bogdanChisalescu/Project-2/Documentation/Project_Documentation.pdf

## Proiect 2 - Documentatie Minisistem pentru irigat plante

Chisalescu Bogdan si Floricel Antonio - Stefan Grupa 432A

Coordonator stiintific: S.l. dr. ing. Valentin Stoica

1

### Cuprins

2

### 1 Cerinta de proiectare

Implementarea unui minisistem pentru irigat plante folosind microcontrolerul Atmel AVR ATmega 164A. Realizarea fizica trebuie efectuata pe o placa de cablaj imprimat cu componente SMD furnizata de catre facultate, insa datorita conditiilor epidemiologice si masurilor luate de Conducerile ETTI si UPB aceasta modalitate de realizare nu a fost posibila; masurile de distantare sociala si invatamant in regim ”online” au facut impractic accesul la aparatura necesara, astfel am decis realizarea proiectului pe placi de prototipare si cu componente THT. Realizarea in formatul SMD + placa de circuit imprimat s-ar fi putut realiza de catre un singur membru al echipei insa in acest mod contributia asupra proiectului ar fi fost sever dezechilibrata. Intelegem ca in urma acestei decizi se pierd anumite avantaje precum stabilitatea cu temperatura, zgomotul redus, costul redus, etc.

### 2 Solutia de implementare propusa

Pentru a implementa minisistemul de irigat plante vom avea nevoie de doua clase principale de componente: senzori si actuatori. Actiunea de a iriga plantele consta in transferul unei cantitati de apa dintr-un rezervor catre plante. Pentru a decide momentul irigarii si a o efectua este nevoie de prelucrarea marimilor fizice implicate si anume umiditatea solului si disponibilitatea apei din rezervor reprezentata prin nivel (inaltimea coloanei de apa). Pentru a extrage si cuantifica aceste marimi vom folosi un senzor de umiditate a solului si unul de nivel. Pentru transportul apei de la rezervor la plante vom folosi ca actuator o minipompa de apa. Pentru a facilita interactiunea cu sistemul al unui posibil utilizator vom dezvolta o aplicatie desktop ce va asigura transmisia de date de configurare plus o serie de informatii despre starea sistemului in timp real.

3

### 3 Schema bloc a sistemului

Schema bloc a sistemului reprezinta arhitectura generala si descrie modul conceptual de interconectare a componentelor. Se poate observa o comunicatie unilaterala intre blocuri precum senzorii si microcontroler si o comunicatie bilaterala intre microcontroler si aplicatia utilizatorului, acestea semnificand sensul de transmitere al informatiei.


Figure 1: Schema bloc a minisistemului de irigat plante

### 4 Incarcarea codului pe microcontroler

Microcontrolerul dispune de mai multe modalitati prin care poate fi programat. Cele care sunt de interes sunt programarea folosind un programator dedicat si programarea folosind un bootloader. Utilizarea programatorului dedicat este simpla intrucat este necesara doar conexiunea sa catre PC prin portul USB si realizarea conxiunilor catre pinii dedicati ai microcontrolerului. Utilizarea bootloaderului presupune intai scrierea acestuia intr-o memorie nonvolatila, spatiul rezervat acestuia fiind in adresele superioare are memoriei Flash de program. Dupa incarcarea bootloaderului nu mai este

4

nevoie de programatorul dedicat deoarece in procesul de programare al microcontrolerului bootloaderul preia controlul folosind ce interfata seriala are la dispozitie, incarca aplicatia ce va rula pe microcontroler in memroia de program si ulterior ii cedeaza acesteia controlul executiei. In aceasta lucrare am optat pentru incarcarea codului cu un programator dedicat deoarece ne confera mai multe functionalitati. Am ales pentru elaborarea codului mediul de dezvoltare Atmel Studio 7 acesta fiind creat special pentru programarea microcontrolerelor fabricate de Atmel. Cu ajutorul Atmel Studio si compilatorului GCC vom crea un fisier cu extensia .hex ce va fi incarcat pe microcontroler de catre softul ”avrdude” folosind comanda ”avrdude -c usbasp -p m164p -U flash:w:$(ProjectDir)Debug $(TargetName).hex:i”. Deoarece avrdude nu ofera suport pentru modelul ATmega 164A, am modificat in fisierul de configurare al avrdude semnatura dispozitivului alegand cel mai apropiat dispozitiv ca arhitectura de ATmega 164A, acesta fiind ATmega 164P.

Figure 2: Modul in care se incarca codul pe uC

### 5 Cuplarea unui oscilator extern

Atmega 164A pune la dispozitie o multitudine de optiuni cand vine vorba de alegerea sursei pentru ceasul intern; acesta vine echipat cu un oscilator RC intern calibrat la frecventa de 8 MHz, iar pentru ceasul de sistem aceasta frecventa este impartita la 8, de unde rezulta 1 MHz, astfel in mod implicit microcontrolerul ruleaza la o frecventa de ceas de 1 MHz. Deoarece aceasta frecventa de 1 MHz este in anumite situatii un factor limitator de performanta vom cupla un oscilator extern cu cristal de quartz de 20 MHz. Pentru a determina microcontrolerul sa foloseasca acest oscilator ca sursa pentru

5

ceasul de sistem este nevoie sa fie modificati bitii fuse. Bitii fuse sunt localizati intr-o zona rezervata din memoria EEPROM iar modificarea acestora se poate face numai cu un programator dedicat deoarece bootloaderul nu poate accesa acel sector al memoriei. Bitii fuse sunt o serie de biti ce ajuta la configurarea microcontrolerului, aceastia formeaza impreuna 3 bytes: High Fuse Byte, Low Fuse Byte si Extended Fuse Byte, pentru fiecare bit ”1” inseamna programat iar ”0” inseamna neprogramat. Pentru a fi siguri ca am programat corect acesti biti am folosit resursa https://www.engbedded.com/fusecalc/, unde am ales tipul de oscilator in conformitate cu foaia de catalog a microcontrolerului adica Full Swing Crystal Oscilator cu timp de pornire cat mai mare ca sa asigure o durata suficienta stabilizarii oscilatiilor si am dezactivat optiunea ce imparte ceasul la 8. Modificarea bitilor fuse a fost efectuata cu programul avrdude folosind comanda ”avrdude -c usbasp -p m164p -U lfuse:w:0xe7:m -U hfuse:w:0x99:m”. Pentru a ne asigura ca microcontrolerul foloseste intradevar frecventa de 20 MHz, am definit in cod frecventa ceasului la un 1 MHz si am tinut aprins un LED timp de 2 secunde. In acest caz frecventa ceasului intern fiind de 1 MHz, LED-ul a stat aprins pentru 2 secunde, exact cat a fost programat(..insert link here...). Am cuplat apoi oscilatorul si am rulat acelasi program, in acest caz LED-ul nu mai sta aprins timp de 2 secunde, ci mult mai putin(...insert linke here...). In cod am definit frecventa de 1 MHz iar microcontrolerul presupune ca aceasta este frecventa ceasului intern si calculeaza in functie de ea timpul pentru care tine LED-ul aprins, iar apoi pentru a-l tine aprins utlizeaza ceasul intern, de aceea chiar daca calculul s-a facut pentru o frecventa de 1 MHz, LED-ul nu va sta aprins pentru 2 secunde deoarece frecventa ceasului este mult mai mare, in acest caz 20 MHz iar timpul in care sta LED-ul aprins este de 0.1 secunde. In urma acestui test putem spune cu exactitate ca microcontrolerul seteaza ceasul intern dupa oscilatorul cuplat.

6

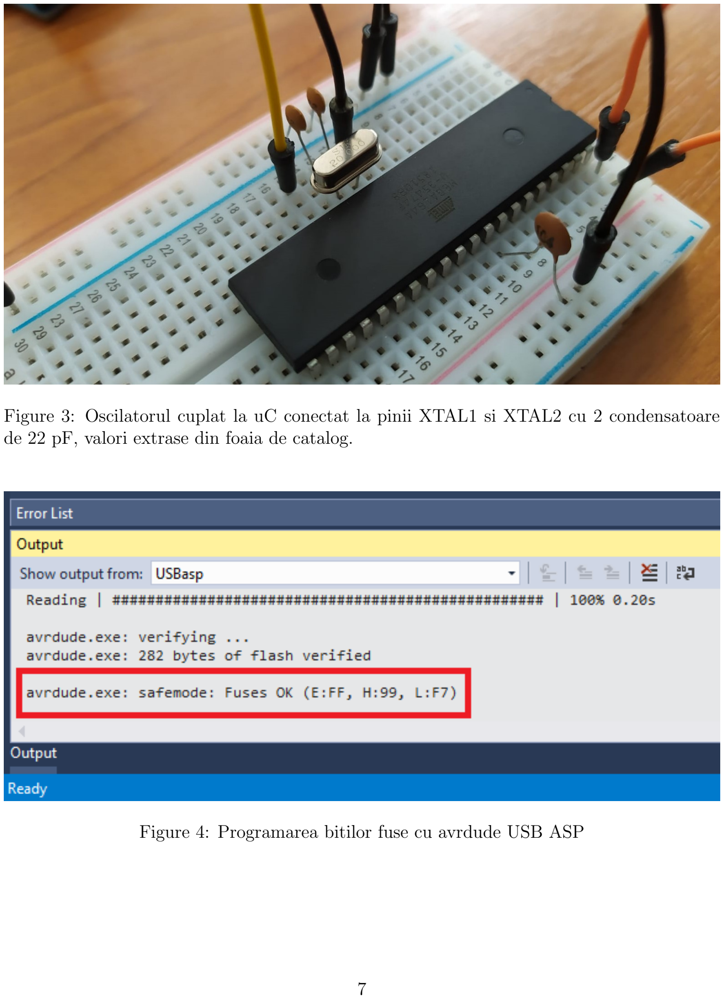
[picture p13: page 7]

Figure 3: Oscilatorul cuplat la uC conectat la pinii XTAL1 si XTAL2 cu 2 condensatoare de 22 pF, valori extrase din foaia de catalog.

Figure 4: Programarea bitilor fuse cu avrdude USB ASP

7

### 6 Comunicatia seriala

Microcontrolerul este capabil de a comunica cu alte dispozitive, aceasta comunicatie asigurandu-se printr-o multitudine de protocoale si interfete, insa ptrintre acestea nu se afla si USB; de aceea pentru a realiza comunicatia intre uC si PC prin intermediul portului USB este nevoie de un convertor USB-TTL. Rolul acestuia este de a adapta interfata folosita de microcontroler pentru comunicatie la cea folosita de PC pentru a se putea efectua schimbul de informatii. Pe tot parcursul desfasurarii proiectului, din cauza lipsei stocului nu am putut face rost de un convertor USB-TTL dedicat, insa am avut la dispozitie o placa de dezvoltare Arduino ce are integrat un astfel de convertor si poate fi configurata sa functioneze si cu alte dispozitive in afara de uC sau integrat. Legand pinul RESET la GND pe placa de dezvoltare Arduino putem suspenda microcontrolerul integrat al placii si folosi convertorul USB-TTL pentru a comunica cu alte dispozitive prin intermediul pinilor RX si TX. Optional, folosind aceasta placa de dezvoltare se poate asigura alimentarea microcontrolerului.


Figure 5: Placa de dezvoltare Arduino folosita pe post de convertor USB-TTL

ATmega 164A dispune de urmatorele moduri de comunicatie seriala: SPI, USART, USART in modul SPI si TWI. Din cauza familiaritatii, usurin-

8

tei de implementare si simplitatii am ales sa folosim interfata USART, iar din cele doua prezente in functionalitatea microcontrolerului USART0 si US-ART1 vom folosi USART0. Pentru o mai mare flexibilitate am ales sa folosim pentru transmiterea si receptionarea datelor modul asincron de lucru, deci se impune setarea unei rate de baud; aceasta este calculata folosind frecventa interna a ceasului si continutul registrului UBBRn. Practic pentru a seta rata de baud este necesara scrierea unei valori in registrul UBBRn, aceasta valoare este deci calculata dupa formula UBBRn =

fOSC
16BAUD − 1. Datele vor
fi transmise in aceasta comunicatie in formate. Un format de date suporta 1 bit de start, 5 pana la 9 biti de date, 1 bit de paritate si unul sau doi biti de stop. Linia de comunicatie ramane la nivelul logic de 1 in starea de asteptare dupa care schimbarea nivelului catre nivelul de 0 logic semnifica aparitia bitului de start, apoi sunt transmisi cei 5 pana la 9 biti de date, bitul de paritate optional si bitii de stop, dupa care linia ramane din nou in asteptare, stare corespunzatoare nivelului de 1 logic pana la urmatoarea transmisie a altui format de date. Deoarece dimensiunea datelor cu care lucram se poate exprima in functie de numarul de octeti pe care il ocupa in memorie, cea mai convenabila alegere este cea de 8 biti de date. In aceasta comunicatie sursele de interferenta sunt minime, astfel ca am deci transmisia fara bitul de paritate iar pentru simplitate ne vom rezuma la un bit de stop.

Figure 6: Formatul de date ales in cadrul acestui proiect

Setarea tuturor parametrilor dar si controlul transmisiei si receptiei se efectueaza cu ajutorul a 3 registre speciale de stare si control: UCSR0A, UCSR0B si UCSR0C. Deoarece timpul nu este o variabila critica in acest proiect am ales o rata de baud de 9600 simboluri/s. Pentru a activa transmisia si receptia se seteaza bitii TXEN0 si respectiv RXEN0 din registrul

9

UCSR0B. Arhitectura AVR a acestui microcontroler ne pune la dispozitie registrul UDR0 pentru schimbul de informatii, registru de deplasare pe 8 biti. In momentul in care acest registru este scris si daca transmisia este activata se va incepe transmiterea lui pe interfata seriala, iar daca receptia este activata, orice date receptionate se vor gasi in acest registru. Desi denumirea este comuna atat pentru receptie cat si pentru transmisie, modul in care este folosit (daca se scrie sau se citeste) determina care registru este adresat (existand astfel 2 registre cu numele de UDR0), USART facilitand o comunicatie full duplex (se poate transmite si receptiona independent).

### 7 Etalonarea senzorilor

De obicei orice componenta electronica activa sau de o compelxitate ridicata este livrata impreuna cu o foaie de catalog de la producator care descrie in detaliu functionarea acesteia. Din cauza bugetului redus am achizitionat senzori ce nu dispun de foi de catalog, ci numai de o serie de parametrii listati de distribuitor. Chiar daca majoritatea senzorilor au o caracteristica ideala liniara am decis ca este necesara etalonarea pentru a garanta functionarea acestor in anumite limite. Ambii senzori, atat cel de nivel cat si cel de umiditate a solului ar trebui ideal sa aiba caracteristici liniare. Senzorii au o marime de intrare reprezentata de marimea fizica ce trebuie masurata si o marime de iesire, pentru ambii senzori reprezentata de o tensiune electrica ce va trebui citita. Pentru a etalona senzorii vom privi ambele marimi ca doua variabile aleatoare, vom prelua date empirice si vom folosi metode statistice pentru a estima parametrii de interes. Vom nota astfel cu X marimea de intrare si cu Y marimea de iesire si vom incerca estimarea liniara a variabilei Y cu ajutorul variabilei X determinand o functie de forma Yˆ = ϕ(X). Pentru a determina aceasta functie vom utiliza metoda celor mai mici patrate prin care ne dorim ca M[(Y − ϕ(X))²
] = min. In cazul nostru cea mai buna estimare este una de tip liniar si neomogen astfel ca Yˆ va fi de forma Yˆ = aX + b, a, b ∈ <. Microcontrolerul va citi variabila Y si va incerca sa estimeze valoarea lui X de aceea dupa determinarea dependentei intre X si Y vom determina inversa functiei adica ϕ

−1
. Pentru ambii senzori am ales sa prelucram datele folosind mediul Matlab si am determinat caracteristica trasand un polinom

10 de gradul unu ce minimizeaza media patratului erorii ε = Y − ϕ(X). In Matlab ne-au fost returnati coeficientii a, b ∈ < ai acestui polinom.

### 7.1 Senzorul de nivel al apei

X = nivelul apei [mm]
Y = tensiunea de iesire [V]
Pentru acest senzor am efectuat 3 masuratori independente, 2 cu senzorul alimentat la 5V cu Vcc mediu de 4.7857V si una la 3V cu Vcc mediu de 3.24V, pentru ultima masuratoare senzorul a prezentat o caracteristica puternic neliniara si nu a fost inclusa in calcule, in acelasi timp ne poate sugera ca functionarea senzorului este mai stabila pentru alimentare la 5V. Pentru a determina valorile coeficientilor am conclus ca media primelor doua masuratori este mai apropiata de valoarea reala.
Din datele masurate am putut extrage a = 0.02795, b = 2.044 ⇒ Yˆ ≈ 0.03X +2, de unde ϕ

−1

(x) = 100x−200
3

, deci am obtinut functia ce face legatura intre tensiunea citita si nivelul apei din rezervor.


Figure 7: Determinarea caracteristicii senzorului de nivel

11

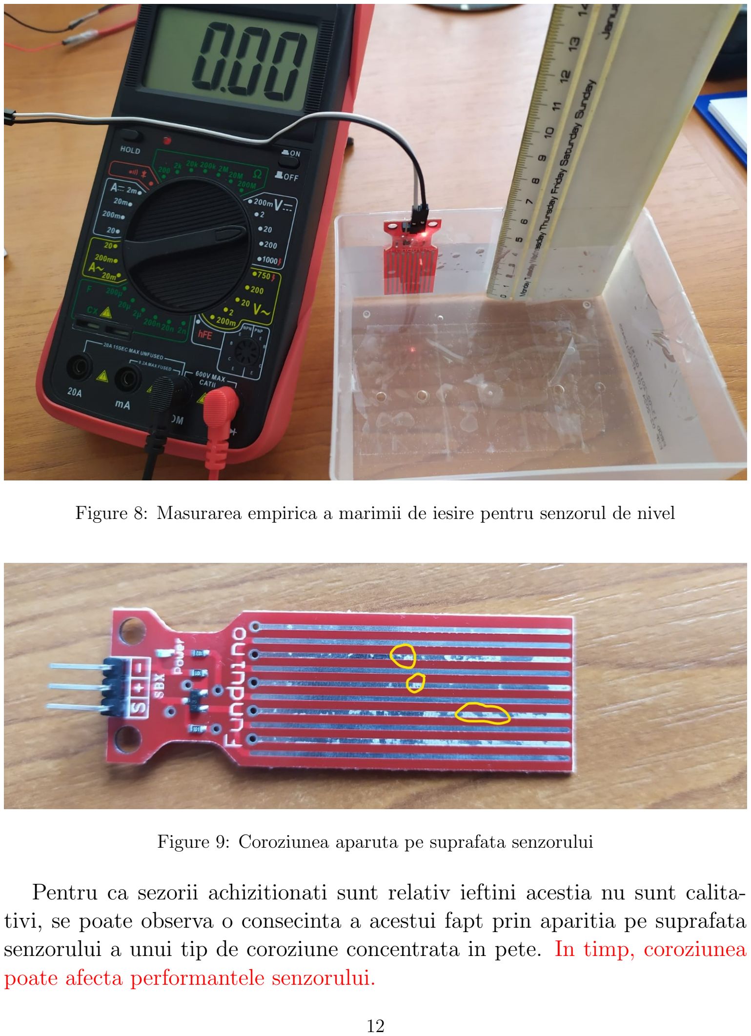
[picture p14: page 12]

Figure 8: Masurarea empirica a marimii de iesire pentru senzorul de nivel

Figure 9: Coroziunea aparuta pe suprafata senzorului

Pentru ca sezorii achizitionati sunt relativ ieftini acestia nu sunt calitativi, se poate observa o consecinta a acestui fapt prin aparitia pe suprafata senzorului a unui tip de coroziune concentrata in pete. In timp, coroziunea poate afecta performantele senzorului.

12

### 7.2 Senzorul de umiditate a solului

X = umiditatea solului [%]
Y = tensiunea de iesire [V]
Am notat greutatea solului umed = gsum si greutatea solului uscat = gsu, astfel putem calcula umiditatea solului exprimata in procente dupa formula umiditatea =

gsum−gsu
gsu
- 100 [%]
Pentru etalonarea senzorului de umiditate am ales o mostra de sol cu greutatea aproximativa de 100 g. Deoarece nu am avut acces la instrumente de precizie aceasta masuratoare este grosiera, ca atare si aproximarea caracteristicii senzorului va fi una grosiera.
Pentru acest senzor am efectuat 3 masuratori insa de data aceasta valorile au fost preluate una dupa cealalta, ceea ce nu ne mai da posibilitatea de a spune ca masuratorile sunt independente, pentru calculul parametrilor am considerat o singura masuratoare unde am mediat fiecare valoare.
Din datele masurate am putut extrage a = −0.042, b = 4.7981 ⇒ Yˆ ≈ −0.04X +4.8, de unde ϕ

−1
(x) = −5(5x−24), deci am obtinut functia ce face legatura intre tensiunea citita si umiditatea solului.


Figure 10: Determinarea carcateristicii senzorului de umiditate

13


Figure 11: Masurarea empirica a marimii de iesire pentru senzorul de umiditate a solului

S-a incercat in paralel si masurarea cu ajutorul microcontrolerului, insa rezultatele furnizate de acesta erau inconsistente si de o deviatie mare fata de valorile date de multimetru, astfel ca nu s-au putut extrage informatii din aceasta masuratoare.

### 8 Actuatorul

Ca actuator pentru a extrage apa din rezervor si a o transporta catre ansamblul de plante am ales o minipompa de apa submersibila. De asemenea si in cazul acesteia din cauza bugetului am achizitionat o pompa ce nu a venit cu o foaie de catalog ci cu o serie de specificatii din partea distribuitorului. Din pacate pompa a ajuns nefunctionala, insa am reusit sa gasim problema si sa o reparam. Minipompa de apa consta dintr-un motor DC si un ansamblu mecanic format dintr-o paleta si o incapere cu 2 orificii, unul prin care apa intra in incapere si unul prin care iese directionata de paleta, ce este la randul sau pusa in miscare de rotatie de catre motor. Problema pentru pompa noastra a fost ca paleta se afla mult prea aproape de corp ceea ce determina

14 o forta de frecare mult prea mare pentru a fi dezvoltata de motor, si in acest mod chair daca era alimentata, pompa nu functiona. Solutia a constat in deplasarea paletei pe axul ce o conecteaza la motor astfel incat sa se reduca frecarea cu corpul pompei. In urma acestei actiuni am reusit sa facem pompa functionala, insa parametrii sai s-au schimbat. Debitul s-a redus de la 1.2-1.4 L/min la aproximativ 0.43 L/min iar consumul sau de curent este usor crescut de la 250-270 mA la aproximativ 300 mA.


Figure 12: Pompa de apa, se poate observa paleta rotativa si incaperea cu cele 2 orificii

Repararea pompei a reprezentat un proces prin care i s-a distrus integritatea fizica insa in cea mai mare masura aceasta a putut fi restaurata. Consumul pompei este de ≈ 300 mA, iar curentul maxim ce poate fi furnizat de unul dintre pinii generali ai microcontrolerului este de 40 mA, ceea ce inseamna ca nu va fi posibila comanda actuatorului direct de catre microcontroler. In acest caz solutia aleasa de noi este comandarea pompei prin intermediul unui tranzistor ce va comuta intre saturatie (”deschis”) si blocare (”inchis”). Pompa va fi amplasata astfel incat curentul consumat sa fie curentul de colector al tranzistorului.

15


Figure 13: Schema prin care se doreste comandarea pompei de apa

Din cauza accesului limitat la piese, explicat in prima sectiune, am folosit cel mai adecvat tranzistor pe care l-am avut la dispozitie, acesta este tranzistorul bipolar NPN de tip 2N2222A. Pentru acest tranzistor am masurat un factor de amplificare static in curent β ≈ 300. Vm reprezinta potentialul ce poate fi furnizat pe unul din pinii microcontrolerului, acesta avand la dispozitie pentru iesire numai pini digitali, deci Vm ≈ Vcc ≈ 5V. Tensiunea de functionare la care vom alimenta pompa este de 5V deci Vr trebuie sa fie minim 5V, pentru functionarea in saturatie s-a ales VCE ≈ 2V ceea ce impune VCC ≈ 7V .

V m = 0 ⇒ VBE = 0; VCC = 7V ⇒ VCE > 0, VCB > 0 ⇒ blocare.

V m = 5V ⇒ VBE > 0; VCC = 7V ⇒ VCE = 2V, VR = 5V, VBC>0 ⇒ saturatie.

In regim de saturatie transzistorul ar trebiu sa prezinte o rezistenta foarte mica colector-emitor pentru a permite curegerea celor 300 mA consumati de pompa.

16

La implementarea practica a circuitului, la momentul aplicarii potentialului Vm, din motive pe care nu le cunoastem uC inceteaza sa functioneze, astfel circuitul nu a putut fi pus in practica. Avem ca solutie alternativa folosirea unui releu in locul tranzistorului.

### 9 Convertorul ADC

Pentru a putea lua orice decizie sau pentru a putea calcula parametrii de interes este nevoie de cuantizarea marimilor citite de la senzori si transformarea acestora sub o forma ce poate fi prelucrata numeric. Microcontrolerul dispune de un convertor ADC ce poate face acesata transformare. Convertorul ADC lucreaza pe 10 biti si poate avea ca referinta de tensiune: pinul extern AREF (referinta interna dezactivata), pinul AVCC cu condendsator cuplat la pinul AREF catre masa, referinta interna de 1.1V sau referinta interna de 2.56V. In acest proiect am ales ca referinta de tensiune pinul AVCC. Tot ce presupune controlul convertorului se face cu ajutorul registrelor AD-CSRA si ADCSRB. Pentru a activa convertorul trebuie setat bitul ADEN din registrul ADCSRA iar pentru a porni o conversie bitul ADSC din acelasi registru. In momentul finalizarii unei conversii, microcontrolerul seteaza bitul ADSC inapoi la 0 iar rezultatul conversiei este scris in registrul de 16 biti ADC format din registrele de 8 biti ADCL si ADCH. Cand ADCL este citit, registrul de date ADC nu este actualizat pana nu se citeste si ADCH.

17

### 10 Schema electrica


Figure 14: Schema electrica a proiectului

18

### 11 BOM (Bill of Materials)

Clasa | Descriere | Distribuitor | Cantitate | Pret unitar
Senzor | Senzor de nivel al apei | Optimus Digital | 1 | 3,29 Lei
Senzor | Senzor de umiditate a solului | Optimus Digital | 1 | 3,99 Lei
Actuator | Mini pompa de apa submersibila | Optimus Digital | 1 | 8,99 Lei
Programator | Programator USB ASP | Optimus Digital | 1 | 7,49 Lei
Stabilizator | Stabilizator de tensiune LM7805 | ETTI | 1 | -
Convertor | Convertor USB TTL | Optimus Digital | 1 | 12,89 Lei
Tranzistor | NPN 2N2222A | Optimus Digital | 1 | 0,99 Lei
Oscilator | Quartz, 20 MHz | ETTI | 1 | -
Condensator | Electrolitic, 1uF | Optimus Digital | 1 | 0,49 Lei
Condensator | Electrolitic, 10uF | Optimus Digital | 1 | 0,49 Lei
Condensator | Ceramic, 22pF | Optimus Digital | 2 | 0,49 Lei
Condensator | Ceramic, 100nF | Optimus Digital | 5 | 0,69 Lei

19

### 12 Codul ce ruleaza pe microcontroler

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

11
12 | union {
13 | f l o a t f ;
14 | ch a r b y t e s [ 4 ] ;
15 | } j oi n e d Fl o a t ;

16
17 | union {
18 | i n t i ;
19 | ch a r b y t e s [ 2 ] ;
20 | } j o i n e d I n t ;

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

24
25 | v oid ADC Init ( ) ;
26 | v oid USART Transmit ( un si gned ch a r data ) ;
27 | v oid USART Init ( un si gned i n t baud ) ;
28 | un si gned ch a r USART Receive ( v oid ) ;
29 | v oid C o n v e r si e ( un si gned ch a r *low , un si gned ch a r * hi gh ) ;
30 | v oid s t a t eC o n n e c t e d ( un si gned ch a r command ) ;
31 | v oid s t a t eR e a di n g ( un si gned ch a r command ) ;
32 | i n t p r ei aD a t eUmi di t a t e ( ) ;
33 | i n t p r ei aD a t eNi v el ( ) ;

34
35 | i n t main ( v oid )
36 | {
37 | // I n i t i a l i z a r e USART
38 | USART Init ( MYUBRR ) ;

39
40 | // I n i t i a l i z a r e ADC
41 | ADC Init ( ) ;

42
43 | //DDRD = 0xFF;
44 | un si gned ch a r command ;
45 | i n t umi di t a t e ; // [%]
46 | i n t n i v e l ; // [mm]

47
48 | w hil e ( 1 )
49 | {

20

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

73
74 | // S e l e c t e a z a c a n al ul ADC0 pen t ru c o n v e r s i e (XOR cu 0x01 )
75 | ADMUX = ADMUX ˆ 0 x01 ;

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

84
85 | un si gned i n t convLow = ADCL; // Citim ADCL
86 | un si gned i n t convHigh = ( un si gned i n t ) (ADCH << 8 ) ; // Citim ADCH s i facem l o c
pen t ru ADCL s hi t a n d l a s t an g a 8 p o z i t i i
87 un si gned i n t conv = convLow | convHigh ; //Concatenam ADCL cu ADCH

88
89 | f l o a t resConv = ( conv * | VREF) / 1 0 2 3 . 0 ; // R e z ul t a t ul c o n v e r s i e i i n V
90 | i n t umi di t a t e = −5 * | ( 5* resConv −24) ; // Umidi ta tea i n p r o c e n t e (0 −100)

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

93
94 }

21

95
96 | // Returneaza n i v e l u l din vas i n mm
97 | i n t p r ei aD a t eNi v el ( ) {

98
99 | // S e l e c t e a z a c a n al ul ADC1 pen t ru c o n v e r s i e (SAU cu 0x01 )
100 | ADMUX = ADMUX ˆ 0 x01 ;

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

109
110 | un si gned i n t convLow = ADCL; // Citim ADCL
111 | un si gned i n t convHigh = ( un si gned i n t ) (ADCH << 8 ) ; // Citim ADCH s i facem l o c
pen t ru ADCL s hi t a n d l a s t an g a 8 p o z i t i i
112 un si gned i n t conv = convLow | convHigh ; //Concatenam ADCL cu ADCH

113
114 | f l o a t resConv = ( conv * | VREF) / 1 0 2 3 . 0 ; // R e z ul t a t ul c o n v e r s i e i i n V
115 | i n t n i v e l = ( 1 0 0 * | resConv − 2 0 0 ) / 3 ; // Ni v el ul i n mm (0−40)

116
117 r e t u r n n i v e l ;

118
119 }

120
121 v oid s t a t eC o n n e c t e d ( un si gned ch a r command ) {

122
123 i n t OK = 0 ;

124
125 w hil e (command == ’ c ’ ) {

126
127 | i f ( !OK) {
128 | USART Transmit ( ’ a ’ ) ; // T r an smi te re mesa j de c o n fi rm a r e i n t r a r e i n s t a r e a
de c o n e c t a t
129 | OK = 1 ;
130 | }
131 | i n t umi di t a t e = p r ei aD a t eUmi di t a t e ( ) ; //Se p r ei a umi di t a t e a
132 | i n t n i v e l = p r ei aD a t eNi v el ( ) ; //Se p r e i a n i v e l u l a p ei
133 | un si gned ch a r *p ;
134 | p = ( un si gned ch a r *)&umi di t a t e ;
135 | USART Transmit (*p++);
136 | USART Transmit (*p ) ;
137 | p = ( un si gned ch a r *)&n i v e l ;
138 | USART Transmit (*p++);
139 | USART Transmit (*p ) ;

140
141 | d el a y m s ( 2 0 0 0 ) ;

22

142

143
144 | | command = UDR0;
145 | | i f (command == ’ r ’ ) {
146 | | s t a t eR e a di n g (command ) ;
147 | | command = UDR0;
148 | | command = ’ c ’ ;
149 | }
150 | | e l s e i f (command != ’b ’ )
151 | | command = ’ c ’ ;

152
153 | }
154 | }

155
156 v oid s t a t eR e a di n g ( un si gned ch a r command ) {

157
158 | i n t i ;
159 | f o r ( i =0; i <4; i++){
160 | | j oi n e d Fl o a t . b y t e s [3− i ] = USART Receive ( ) ;
161 | }

162
163 c a n ti t a t eA p a = j oi n e d Fl o a t . f ;

164
165 | f o r ( i =0; i <2; i++){
166 | | j o i n e d I n t . b y t e s [1− i ] = USART Receive ( ) ;
167 | }

168
169 | umidi t a teP r a g = j o i n e d I n t . i ;
170 | }

171

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

183
184 | v oid USART Init ( un si gned i n t baud )
185 | {
186 | /* | Se t baud r a t e */
187 | UBRR0H = ( un si gned ch a r ) ( baud>>8) ;
188 | UBRR0L = ( un si gned ch a r ) baud ;
189 | /* | Enable r e c e i v e r and t r a n smi t t e r */
190 | UCSR0B = (1<<RXEN0)|(1<<TXEN0) ;
191 | /* | Se t frame forma t : 8data , 2 s t o p b i t */
192 | UCSR0C = (1<<USBS0)|(3<<UCSZ00 ) ;

23

193 }

194
195 | v oid USART Transmit ( un si gned ch a r data )
196 | {
197 | /* | Wait f o r empty t r a n smi t b u f f e r */
198 | w hil e ( ! ( UCSR0A & (1<<UDRE0) ) )
199 | ;
200 | /* | Put data i n t o b u f f e r , send s the data */
201 | UDR0 = data ;
202 | }

203
204 | un si gned ch a r USART Receive ( v oid )
205 | {
206 | /* | Wait f o r data t o be r e c e i v e d */
207 | w hil e ( ! (UCSR0A & (1<<RXC0) ) )
208 | ;
209 | /* | Get and r e t u r n r e c e i v e d data from b u f f e r */
210 | r e t u r n UDR0;
211 | }

24

### 13 Codul aplicatiei de utilizator

1
2 | u si n g System ;
3 | u si n g System . C o l l e c t i o n s . Gene ric ;
4 | u si n g System . ComponentModel ;
5 | u si n g System . Data ;
6 | u si n g System . Drawing ;
7 | u si n g System . Linq ;
8 | u si n g System . Text ;
9 | u si n g System . Threading . Tasks ;
10 | u si n g System . Windows . Forms ;

11
12 | namespace P2
13 | {
14 | p u bli c p a r t i a l c l a s s Form1 : Form
15 | {
16 | b o ol i sC onnec ted = f a l s e ;
17 | p u bli c Form1 ( )
18 | {
19 | I ni ti ali z e C om p o n e n t ( ) ;
20 | s t a t e L a b el . Text = ” Nec onec t a t ” ;
21 | buttonDeconnect . Enabled = f a l s e ;
22 | labelUmidVal . Text = ”N/A” ;
23 | l a b e l N i v el V a l . Text = ”N/A” ;
24 | textBoxUmid . Text = ”0” ;
25 | textBoxCantApa . Text = ”0” ;
26 | textBoxUmid . Enabled = f a l s e ;
27 | textBoxCantApa . Enabled = f a l s e ;
28 | buttonSend . Enabled = f a l s e ;
29 | }

30
31 | p r i v a t e v oid Form1 Load ( o b j e c t sende r , EventArgs e )
32 | {
33 | comBox . I tems . Add( ”COM1” ) ;
34 | comBox . I tems . Add( ”COM2” ) ;
35 | comBox . I tems . Add( ”COM3” ) ;
36 | comBox . I tems . Add( ”COM4” ) ;
37 | comBox . I tems . Add( ”COM5” ) ;
38 | comBox . S el e c t e d I n d e x = 0 ;
39 | S e r i a l P o r t . PortName = comBox . S el e c t e d I t em . T oS t rin g ( ) ;
40 | }

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

49

25

50 | S e r i a l P o r t . Open ( ) ;
51 | S e r i a l P o r t . Wri teLine ( ” c ” ) ;
52 | ch a r ack = ( ch a r ) S e r i a l P o r t . ReadChar ( ) ;
53 | i f ( ack == ’ a ’ )
54 | {
55 | i sC onnec ted = t r u e ;
56 | byte [ ] b = new by te [ 2 ] ;
57 | b [ 0 ] = ( by te ) S e r i a l P o r t . ReadByte ( ) ;
58 | b [ 1 ] = ( by te ) S e r i a l P o r t . ReadByte ( ) ;
59 | i n t r e al tim e v a l u e = b [ 1 ] ;
60 | r e al ti m e v al u e = r e al tim e v al u e << 8 ;
61 | r e al ti m e v al u e += b [ 0 ] ;
62 | labelUmidVal . Text = r e al t im e v al u e . T oS t rin g ( ) + ” %” ;

63
64 | b [ 0 ] = ( by te ) S e r i a l P o r t . ReadByte ( ) ;
65 | b [ 1 ] = ( by te ) S e r i a l P o r t . ReadByte ( ) ;
66 | r e al ti m e v al u e = b [ 1 ] ;
67 | r e al ti m e v al u e = r e al tim e v al u e << 8 ;
68 | r e al ti m e v al u e += b [ 0 ] ;
69 | l a b e l N i v el V a l . Text = r e a l ti m e v al u e . T oS t rin g ( ) + ” mm” ;
70 | }
71 | }

72
73 | p r i v a t e v oid comBox SelectedIndexChanged ( o b j e c t sende r , EventArgs e )
74 | {
75 | S e r i a l P o r t . PortName = comBox . S el e c t e d I t em . T oS t rin g ( ) ;
76 | }

77
78 | p r i v a t e v oid b u t t o nD e c o n n e c t Cli c k ( o b j e c t sende r , EventArgs e )
79 | {
80 | S e r i a l P o r t . Wri teLine ( ”b” ) ;
81 | buttonConnect . Enabled = t r u e ;
82 | buttonDeconnect . Enabled = f a l s e ;
83 | textBoxUmid . Enabled = f a l s e ;
84 | textBoxCantApa . Enabled = f a l s e ;
85 | buttonSend . Enabled = f a l s e ;
86 | }

87
88 | p r i v a t e v oid bu t t onUpd a te Clic k ( o b j e c t sende r , EventArgs e )
89 | {
90 | buttonUpdate . Enabled = f a l s e ;
91 | i f ( S e r i a l P o r t . IsOpen && i sC onnec ted )
92 | {
93 | byte [ ] b = new by te [ 2 ] ;
94 | b [ 0 ] = ( by te ) S e r i a l P o r t . ReadByte ( ) ;
95 | b [ 1 ] = ( by te ) S e r i a l P o r t . ReadByte ( ) ;
96 | i n t r e a l tim e v a l u e = b [ 1 ] ;
97 | r e al ti m e v al u e = r e al tim e v al u e << 8 ;
98 | r e al ti m e v al u e += b [ 0 ] ;
99 | labelUmidVal . Text = r e al t im e v al u e . T oS t rin g ( ) + ” %” ;

100

26

101 | b [ 0 ] = ( by te ) S e r i a l P o r t . ReadByte ( ) ;
102 | b [ 1 ] = ( by te ) S e r i a l P o r t . ReadByte ( ) ;
103 | r e al ti m e v al u e = b [ 1 ] ;
104 | r e al ti m e v al u e = r e al tim e v al u e << 8 ;
105 | r e al ti m e v al u e += b [ 0 ] ;
106 | l a b e l N i v el V a l . Text = r e a l ti m e v al u e . T oS t rin g ( ) + ” mm” ;

107
108 | }
109 | buttonUpdate . Enabled = t r u e ;
110 | }

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

114
115 | i f ( textBoxUmid . Text != ”” && textBoxCantApa . Text != ”” )
116 | {
117 | f l o a t c a n ti t a t eA p a = f l o a t . Pa rse ( textBoxCantApa . Text ) ;
118 | S e r i a l P o r t . Wri teLine ( ” r ” ) ;
119 | i sC onnec ted = f a l s e ;
120 | byte [ ] b = Bi tC o n v e r t e r . GetBytes ( c a n ti t a t eA p a ) ;
121 | S e r i a l P o r t . Wri teLine ( b [ 0 ] . T oS t rin g ( ) ) ;
122 | S e r i a l P o r t . Wri teLine ( b [ 1 ] . T oS t rin g ( ) ) ;
123 | S e r i a l P o r t . Wri teLine ( b [ 2 ] . T oS t rin g ( ) ) ;
124 | S e r i a l P o r t . Wri teLine ( b [ 3 ] . T oS t rin g ( ) ) ;

125
126 | i n t umidi t a teP r a g = i n t . Pa r se ( textBoxUmid . Text ) ;
127 | byte [ ] bi = Bi tC o n v e r t e r . GetBytes ( umidi t a teP r a g ) ;
128 | S e r i a l P o r t . Wri teLine ( bi [ 0 ] . T oS t rin g ( ) ) ;
129 | S e r i a l P o r t . Wri teLine ( bi [ 1 ] . T oS t rin g ( ) ) ;

130
131 | S e r i a l P o r t . Wri teLine ( ”x” ) ;
132 | i sC onnec ted = t r u e ;
133 | }
134 | }

135
136 | p r i v a t e v oid Form1 FormClosed ( o b j e c t sende r , FormClosedEventArgs e )
137 | {
138 | S e r i a l P o r t . Wri teLine ( ”b” ) ;
139 | S e r i a l P o r t . Cl o se ( ) ;
140 | }
141 | }
142 | }

27

### 14 Bibliografie

https://www.youtube.com/watch?v=IyGwvGzrqp8& list=WL& index=8& t=0s

https://www.youtube.com/watch?v=F7NlCaaL3yU& list=WL& index=8& t=0s

https://www.instructables.com/id/Serial-Port-Programming-With-NET/

https://www.edn.com/usart-vs-uart-know-the-difference/

https://www.allaboutcircuits.com/textbook/digital/chpt-3/logic-signalvoltage-levels/

https://www.edaphic.com.au/soil-water-compendium/soil-moisture-sensorcalibration/

https://electronics.stackexchange.com/questions/112441/using-a-transistoras-a-switch

https://www.instructables.com/id/Avr-fuse-basics-Running-an-avr-withan-external-cl/

https://www.engbedded.com/fusecalc/

https://app.diagrams.net/

https://www.avrfreaks.net/forum/converting-4-bytes-float-help

28
