bogdanChisalescu/Project-2/Documentation/Pictures/test.png

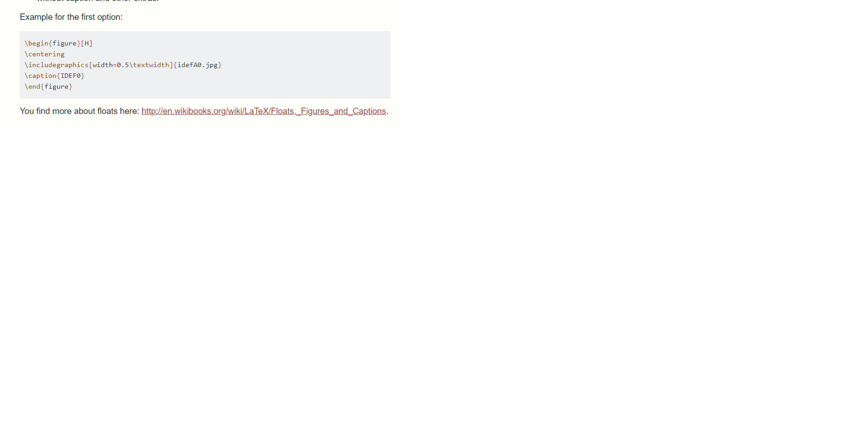
Documentation/Pictures/test.png
