bogdanChisalescu/Project-2/(commit log)

2020-04-19 Efectuat prima masuratoare empirica pentru etalonarea senzorului de nivel al apei
2020-05-03 Initiated the project for uC in Atmel Studio and implemented a test program, connection to board was not successful
2020-05-07 Changed time parameter on the test program of the uC, connection to board was successful
2020-05-09 Made a second and third measurement for the water level sensor and also applied a linear regression algorithm to determin it's curve
2020-06-07 Tried reading an analog voltage and transfer the result of the conversion to PC, results were very inconsistent, tried with AVCC and AREF
